Gallard88/Sunfish_MK2/2.Requirements/1.Requirements.md

ROSV Sunfish, MK2
=======

Processor
-----------
* Single Board Computer (SBC)
* Linux based OS.
* Capable of running the ROS framework.

Sensors
-----------
* Supply voltage measurement.
* Current measurement.
* Internal Temperature Monitoring.
* External Temperature Monitoring.
* Depth Measuring.
* Capable of Inertial Navigation.

Camera
-----------
* Minimum 640x480.
* Minimum 10fps resolution.
* Maximum 500ms delay.
* Sufficient lighting to see while at maximum depth.
* Sufficient storage to record all video while operating.

Motion/Control
-----------
* 4 axis control (Forward, Strafe, Turn, Dive).
* Minimum 1 hour run time.

Environment
-----------
* Able to dive to a depth of at least 5 meters.
* Tetherd to a surface control system.
* Dimensions of less than 40cm W x 40cm L x 25 cm H.

Tether 
=======

The tether will consist of an Ethernet cable & 2 conductors carrying power.

Ethernet:
-----------
* Cable type: CAT5 or 6.
* Length: 30m.

Power Cables
-----------
* Cable Type: 8 - 12 AWG, preferably 10.
* Length: 30m.

SCS
=======

The SCS contains the power supply for the entire ROSV system. It also contains the brains behind the LAN.
Thus is will need to manage several batteries and will provide power to a number of sub systems. It will be handy if the system can charge the batteries in system.

Power In
-----------
* Min 3x 12V SLA Batteries.
* Intergrated SLA battery charger.

Power Out
-----------
* Min 2x High current fused outputs.
* Min 1x Low current fused outputs.
* Min 1x USB 5V Outputs.

Display
-----------
Minimum Resolution 1024x768.

Processor
-----------
* Single Board Computer (SBC).
* Linux based OS.
* Attached Monitor.
* Runs ROS framework.

Motion/Control
-----------
* Gamepad and/or Joystick3.
* Keyboard and Mouse.

Network
-----------
* Wifi Access Point.
* DHCP Server.
* Network switch, Min 4 ports, Gigabit Ethernet.

Environment
-----------
* Self Contained.
* Easy to transport.
* Water Resistant.
* Small form factor where possible.
