Gallard88/Sunfish_MK2/2.Requirements/2.Tether_Hardware_Requirements.md

Tether 
=======

The tether will consist of an Ethernet cable & 2 conductors carrying power.

Ethernet:
-----------
Cable type: CAT5e or 6
Length: 30m.

Power Cables
-----------
Cable Type: 8 - 12 AWG, preferably 10.
Length: 30m.
