Gallard88/Sunfish_MK2/2.Requirements/4.ROSV_Firmware_Requirements.md

Sensor Data
-----------

Supply Voltage
Current Measurement
Internal Temperature
External Temperature
Depth Measuring
Interntial Navigation:
* Roll
* Pitch
* Yaw

High Side switch. 
PWM Frequency (0 - 2 KHz)
PWM Duty (0 - 100%)

System Values
-----------

Supply Voltage, 16bit, unsigned, millivolts.
Current Measurement, 16bit, unsigned, milliamps.
Internal Temperature, 16bit, signed, 1 degrees Centigrade.
External Temperature, 16bit, signed, 1 degrees Centigrade.
Depth Pressure, 32 bit, signed, Pascals.
Calulated Depth, 32 bit signed, millimeters.
