Gallard88/Sunfish_MK2/2.Requirements/5.USB_Coms_Protocol_Spec.md

USB Coms Protocol.
=======

Packet Types:
-----------
0x0100 - Sensor Data
0x0101 - INS Data
0x0102 - Supply Voltage Data
0x0103 - Supply Current Data

0x0200 - Fluid Density
0x0201 - Set Output
0x0202 - Disable All Outputs

Packets To uC.
=======

1. Set Fluid Density.
-----------
Freq: n/a
Byte
00 - 0x02 Packet Type (MSB)
01 - 0x00 Packet Type (LSB)
02 - Fluid Density (MSB)
03 - Fluid Density (LSB) 

2. Set Output.
-----------
Freq: n/a
Byte
00 - 0x02 Packet Type (MSB)
01 - 0x01 Packet Type (LSB)
02 - Output Channel #
03 - Duty (%)

2. Disable All Outputs
-----------
Freq: n/a
Byte
00 - 0x02 Packet Type (MSB)
01 - 0x02 Packet Type (LSB)
02 - 0xAA
03 - 0x55

Packets From uC.
=======

1. Sensor Data
-----------
Freq: 1Hz
Byte
00 - 0x01 Packet Type (MSB)
01 - 0x00 Packet Type (LSB)
02 - Supply Voltage (MSB)
03 - Supply Voltage (LSB) 
04 - Supply Current (MSB)
05 - Supply Current (LSB) 
06 - Internal Temperature (MSB)
07 - Internal Temperature (LSB) 
08 - External Temperature (MSB)
09 - External Temperature (LSB) 

1. INS Data
-----------
00 - 0x01 Packet Type (MSB)
01 - 0x01 Packet Type (LSB)
02 - Fluid Density (MSB)
03 - Fluid Density (LSB) 

04 - Depth Pressure (MSB)
05 - Depth Pressure  
06 - Depth Pressure  
07 - Depth Pressure (LSB) 

08 - Calulated Depth (MSB)
09 - Calulated Depth
10 - Calulated Depth
11 - Calulated Depth (LSB) 

To Add:
Interntial Navigation:
* Roll
* Pitch
* Yaw

3. Supply Voltage Data
-----------
Measured Supply Voltage. Sampled at 10Hz.
Freq: 1Hz
Byte
00 - 0x01 Packet Type (MSB)
01 - 0x02 Packet Type (LSB)
02 - Supply Voltage[0] (MSB)
03 - Supply Voltage[0] (LSB)
...
20 - Supply Voltage[9] (MSB)
21 - Supply Voltage[9] (LSB) 

4. Supply Current Data
-----------
Measured Supply Voltage. Sampled at 100Hz.
Freq: 1Hz
Byte
 00 - 0x01 Packet Type (MSB)
 01 - 0x03 Packet Type (LSB)
 02 - Supply Current[0] (MSB)
 03 - Supply Current[0] (LSB)
...
200 - Supply Current[100] (MSB)
201 - Supply Current[100] (LSB)
