Gallard88/Sunfish_MK2/Calculations/Hole_Notes.md

Primary Tube
-----------
1. Vacuum Seal
2. Power In
3. USB 1
4. USB 2
5. Ethernet
6. Depth Sensor
7. ???

Secondary Tube, Plate A
-----------
1. Vacuum Seal
2. Supply In +
3. Supply In -
4. USB In
5. Power Out 1
6. Power Out 2
7. ???

Secondary Tube, Plate B
-----------
1. TC 1 + 2
2. TC 3 + 4
3. TC 5 + 6
4. TC 7 + 8
5. TC 9 + 10 (?)
6. Lighting Ch 1
7. Lighting Ch 2
