Gallard88/Sunfish_MK2/Calculations/Output_Notes.md

8 Thrusters
2 Light Outputs
2 Extra outputs
---
12 Channels

= 24 Terminals.

12x 3.5mm screw terminals
= 42mm

12x 3.81mm screw terminals
= 45.72mm

Control Box
6x 12v Socket + Switch
Up to 6 12V Batteries.
Hot plug support.
In built charger.
