Gallard88/Sunfish_MK2/Research/SingleBoardProcessors.md

Single Board Computers
===========

Raspberry Pi 2
-----------
Price: $35USD.
Processor: 900 MHz quad-core ARM Cortex-A7
RAM: 1GB DDR3
GPU: Mali400MP2 GPU @600MHz
Product size: 85.6mm × 56.5mm
Weight: 50g
Ethernet: 10/100M Ethernet RJ45
USB: 
* Four USB 2.0 HOST.

Supported OS:
* Ubuntu 
* Custom Debian 
* Windows 10 IoT

Other features:	

Raspberry Pi 3
-----------
Price: $35USD.
Processor: 1.2GHz 64-bit quad-core ARM Cortex-A53 CPU
RAM: 1GB DDR3
GPU: Mali400MP2 GPU @600MHz
Product size: 85.6mm × 56.5mm
Weight: 50g
Ethernet: 10/100M Ethernet RJ45
USB: 
* Four USB 2.0 HOST.

Supported OS:
* Ubuntu 
* Custom Debian 
* Windows 10 IoT

Other features:	
* Onboard WIFI, Bluetooth 4.1

Odroid XU4
-----------
Price: $74USD.
Processor: Exynos 5422 Octa big.LITTLE ARM Cortex-A15 @ 2.0 GHz quad-core and Cortex-A7 quad-core CPUs
RAM: 2GB DDR3
GPU: Mali-T628 MP6 
Product size: 83mm × 59mm
Weight: 50g
Ethernet: 10/100/1000M Ethernet RJ45
USB: 
* Four USB 2.0 HOST.
* One  USB 2.0 OTG

Supported OS:
* Android 
* Ubuntu 
* Debian 

Odroid-C1+
-----------
Price: $32USD.
Processor: Amlogic S805, 4× Cortex-A5 @ 1.5 GHz
RAM: 1GB DDR3
GPU: Mali450MP2 GPU
Product size: 85mm × 56mm
Weight: 50g
Ethernet: 10/100/1000M Ethernet RJ45
USB: 
* Four USB 2.0 HOST.
* One  USB 2.0 OTG

Supported OS:
* Android 
* Ubuntu 
* Debian 

Other features:	
* 40 Pins Header,compatible with Raspberry Pi B+

Odroid-C2
-----------
Price: $40USD.
Processor: Amlogic S905, 4× Cortex-A53 (ARMv8 64bit)
RAM: 2GB DDR3
GPU: Mali450MP3
Product size: 85mm × 56mm
Weight: 50g
Ethernet: 10/100/1000M Ethernet RJ45
USB: 
* Four USB 2.0 HOST.
* One  USB 2.0 OTG

Supported OS:
* Android 
* Ubuntu 
* Debian 

Other features:	
* 40 Pins Header,compatible with Raspberry Pi B+

Orange Pi Plus
-----------
Price: $40USD.
Processor: H3 Quad-core Cortex-A7 H.265/HEVC 4K
RAM: 1GB DDR3
GPU: Mali400MP2 GPU @600MHz
Product size: 108mm × 60mm
Weight: 50g
Ethernet: 10/100/1000M Ethernet RJ45
USB: 
* Four USB 2.0 HOST.
* One  USB 2.0 OTG

Supported OS:
* Android 
* Ubuntu 
* Debian 
* Rasberry Pi Image

Other features:	
* Onboard WIFI, Realtek RTL8189ETV, IEEE 802.11 b/g/n
* 40 Pins Header,compatible with Raspberry Pi B+
