Gallard88/Sunfish_MK2/Testing/WebCamLight_RevA.FootprintCheck.xlsx

Description | Designator | Footprint | LibRef | Manufacturer | Manufacturer P/N | Checked
WL-SMCW SMD CHIP LED WATERCLEAR | LD1_A1, LD1_A2, LD1_A3, LD1_A4, LD1_A5, LD1_A6, LD1_A7, LD1_A8, LD1_A9, LD1_A10, LD1_A11, LD1_A12, LD1_A13, LD1_A14, LD1_A15, LD1_A16, LD2_A1, LD2_A2, LD2_A3, LD2_A4, LD2_A5, LD2_A6, LD2_A7, LD2_A8, LD2_A9, LD2_A10, LD2_A11, LD2_A12, LD2_A13, LD2_A14, LD2_A15, LD2_A16, LD3_A1, LD3_A2, LD3_A3, LD3_A4, LD3_A5, LD3_A6, LD3_A7, LD3_A8, LD3_A9, LD3_A10, LD3_A11, LD3_A12, LD3_A13, LD3_A14, LD3_A15, LD3_A16 | Wurth_1206_Led | LED_White_1206 | Wurth | 158301260 | Visually Inspected
20-60mA Led Driver | U1_A1, U1_A2, U1_A3, U1_A4, U1_A5, U1_A6, U1_A7, U1_A8, U1_A9, U1_A10, U1_A11, U1_A12, U1_A13, U1_A14, U1_A15, U1_A16 | SOT192P237X110-4M | IC_LED_DRV_BCR401R | Infineon | BCR401R | Visually Inspected
