Gallard88/Sunfish_MK2/Testing/Sunfish_ECU_RevA.FootprintCheck.xlsx

Description | Designator | Footprint | LibRef | Manufacturer | Manufacturer P/N | Checked
Ferrite Bead, 6A | FB1, FB2, L1_UF1, L1_UF2, L1_UF3, L1_UF4, L1_UF5, L1_UF6, L1_UF7, L1_UF8, L1_UF9, L1_UF10, L1_UF11, L1_UF12, L3, L5 | 1806 | IND_FERRITE_ BLM41PG600SN1L | MURATA | BLM41PG600SN1L
 | INS1 | IC_INC_BNO055 | IC_INS_BNO055
WR-TBL Terminal Blocks Serie 2301 - 3.50 mm with Rising Clamp | J1, J2, J3, J4, J5, J6 | 691230110004 | TRM_4_Double | W¨¹rth Elektronik eiSos GmbH
CON_4_Pos_Header | J7, J8 | DF13-4P-1.25DSA | CON_4_Pos_Header | Hirose Electric Co Ltd | DF13-4P-1.25DSA
FIXED IND 4.7UH 6.2A 34 MOHM | L2 | Wurth744771156 | IND_4.7uH_6A2 | Wurth Electronics Inc | 74437356047
CHOKE COM MODE ULTRA HC 100 OHMS | L4 | Choke_CM5441Z101B-10 | CHOKE_COM_MODE_100MHz | Laird-Signal Integrity Products | CM5441Z101B-10
WL-SMCW SMD CHIP LED WATERCLEAR | LD1, LD2, LD3 | 0805DIODE | LED_Green_0805 | Wurth | 150080VS75000
USB B Socket Horizontal | SK1 | USB_B_Horizontal | USB_B_Horizontal | Wurth Electronics Inc | 61400416121
IDC BOX HEADER .100" 20POS | TRM1 | IDC20_BOXED | TRM_IDC20 | CNC Tech | 3020-20-0100-00
TERM BLOCK 2POS HORIZ 7.62MM T/H | TRM3 | TERM_2POS_HORIZ_7.62MM | TRM_2way_ScrewTerminal_7.62mm | Altronics | P4343
TERM BLOCK 2POS HORIZ 5.08MM T/H | TRM6 | TERM_2POS_HORIZ_5.08MM | TRM_2way_ScrewTerminal | Wurth Electronics Inc | 691216510002
64 Pin, 512KB Flash, 128K SRAM | U1 | TSQFP50P1200X1200X160-64M | IC_MICRO_ATSAM4S8BA-AU | Atmel | ATSAM4S8BA-AU
TVS DIODE 5.25VWM 8SOIC | U2 | SO-8 | IC_USB_Transorb | STMicroelectronics | USB6B1RL
IC HISIDE PWR SWITCH 4CH PDSO-20 | U3, U4, U5 | SOIC127P1030X265-20M | IC_HSS_BTS724G | Infineon | BTS724GXUMA1
SMPS | U6 | PSOP-8 | IC_SMPS_TPS54531 | TI | TPS54531DDA
IC REG LDO 3.3V 0.7A SOT25 | U7 | SOT-25-A | IC_XC6210B332MR-G | Torex Semiconductor Ltd | XC6210B332MR-G
MCP3202, 12 Bit, 2 CH ADC | U8 | SO-8 | IC_ADC_MCP3202 | Microchip | MCP3202
IC DATAFLASH 32MB 85MHZ 8SOIC | U9 | SOIC127P800X216-8M | IC_Dataflash_32MBit | Adesto Technologies | AT45DB321E-SHF-T
IC OPAMP CURR SENSE 230KHZ 8SOIC | U10 | SOIC127P600X168_HS-8M | IC_OPAMP_MAX9920+ | Maxim Intergrated | MAX9920ASA+
Crystal 12.0000MHz 30ppm 12pF 40 Ohm -20°C - 70°C Surface Mount 4-SMD, No Lead (DFN, LCC) | X1 | XTAL_5X3.2_SMD | XTAL_12MHZ_SMT | TXC CORPORATION | 7B-12.000MAAE-T
