Gallard88/Sunfish_MK2/Testing/SurfaceControlSystem_RevA.FootprintCheck.xlsx

Description | Designator | Footprint | LibRef | Manufacturer P/N | Checked
FUSE CLIP BLADE 500V 30A PCB | F1, F2, F3, F4, F5_UB1, F5_UB2, F5_UB3, F5_UB4 | FUSEHOLDER_BLADE | FUSE_BLADE_500V_30A_PCB | 3522-2
CON_5mm_6.3MM_SPADE | J1_UB1, J1_UB2, J1_UB3, J1_UB4, J2_UB1, J2_UB2, J2_UB3, J2_UB4 | CON_5mm_6.3MM_SPADE | CON_5mm_6.3MM_SPADE | P-850
FIXED IND 4.7UH 6.2A 34 MOHM | L2 | Wurth744771156 | IND_4.7uH_6A2 | 74437356047
FIXED IND 56UH 2.01A 110 MOHM | L3 | Wurth744771156 | IND_56uH_2.01A | 744771156
MOSFET N-CH 30V 20A LFPAK | Q1_UB1, Q1_UB2, Q1_UB3, Q1_UB4, Q2_UB1, Q2_UB2, Q2_UB3, Q2_UB4 | SO-8 | Q_AO4578 | AO4578
USB A Double Socket | SKT2 | USB_A_DoubleSocket | USB_A_Double
TERM BLOCK 2POS HORIZ 7.62MM T/H | TRM1, TRM3, TRM4 | TERM_2POS_HORIZ_7.62MM | TRM_2way_ScrewTerminal_7.62mm | P4343
TERM BLOCK 2POS HORIZ 5.08MM T/H | TRM2, TRM5, TRM6, TRM7 | TERM_2POS_HORIZ_5.08MM | TRM_2way_ScrewTerminal | 691216510002
SMPS | U1 | PSOP-8 | IC_SMPS_TPS54531 | TPS54531DDA
Ideal Diode Controller | U2_UB1, U2_UB2, U2_UB3, U2_UB4 | TSOP65P490X110-8M | IC_LTC4359 | LTC4359CMS8#PBF
IC REG BUCK 5V 1A 8SOPWRPAD | U3 | PSOP-8 | IC_REG_LM22675 | LM22675MRE-5.0/NOPB
