Gallard88/Sunfish_MK2/Calculations/Cable_Loss.ods

Sheet: Cables_Loss
Cable Data |  |  |  |  |  | Voltage Drop
Guage | Diameter | Ohms/Km | Ohms/m | Area (mm^2) | Current: | 5 | A | Current: | 10 | A | Current: | 15 | A | Current: | 20 | A | Current: | 25 | A
 |  |  |  |  | 30 | 50 | 100 | 30 | 50 | 100 | 30 | 50 | 100 | 30 | 50 | 100 | 30 | 50 | 100
0 | 8.3 | 0.3 | 0.0003 | 53.4561625 | 0.09 | 0.15 | 0.30 | 0.18 | 0.30 | 0.60 | 0.27 | 0.45 | 0.90 | 0.36 | 0.60 | 1.20 | 0.45 | 0.75 | 1.50
1 | 7.3 | 0.4 | 0.0004 | 42.31379729 | 0.12 | 0.20 | 0.40 | 0.24 | 0.40 | 0.80 | 0.36 | 0.60 | 1.20 | 0.48 | 0.80 | 1.60 | 0.60 | 1.00 | 2.00
2 | 6.5 | 0.5 | 0.0005 | 33.1830724 | 0.15 | 0.25 | 0.50 | 0.30 | 0.50 | 1.00 | 0.45 | 0.75 | 1.50 | 0.60 | 1.00 | 2.00 | 0.75 | 1.25 | 2.50
3 | 5.8 | 0.7 | 0.00065 | 26.42079422 | 0.20 | 0.33 | 0.65 | 0.39 | 0.65 | 1.30 | 0.59 | 0.98 | 1.95 | 0.78 | 1.30 | 2.60 | 0.98 | 1.63 | 3.25
4 | 5.1 | 0.8 | 0.0008 | 20.42820623 | 0.24 | 0.40 | 0.80 | 0.48 | 0.80 | 1.60 | 0.72 | 1.20 | 2.40 | 0.96 | 1.60 | 3.20 | 1.20 | 2.00 | 4.00
5 | 4.6 | 1.0 | 0.001 | 16.61902514 | 0.30 | 0.50 | 1.00 | 0.60 | 1.00 | 2.00 | 0.90 | 1.50 | 3.00 | 1.20 | 2.00 | 4.00 | 1.50 | 2.50 | 5.00
6 | 4.1 | 1.2 | 0.0012 | 13.20254313 | 0.36 | 0.60 | 1.20 | 0.72 | 1.20 | 2.40 | 1.08 | 1.80 | 3.60 | 1.44 | 2.40 | 4.80 | 1.80 | 3.00 | 6.00
7 | 3.6 | 1.6 | 0.0016 | 10.1787602 | 0.48 | 0.80 | 1.60 | 0.96 | 1.60 | 3.20 | 1.44 | 2.40 | 4.80 | 1.92 | 3.20 | 6.40 | 2.40 | 4.00 | 8.00
8 | 3.2 | 2.0 | 0.002 | 8.042477193 | 0.60 | 1.00 | 2.00 | 1.20 | 2.00 | 4.00 | 1.80 | 3.00 | 6.00 | 2.40 | 4.00 | 8.00 | 3.00 | 5.00 | 10.00
9 | 2.9 | 2.6 | 0.0026 | 6.605198554 | 0.78 | 1.30 | 2.60 | 1.56 | 2.60 | 5.20 | 2.34 | 3.90 | 7.80 | 3.12 | 5.20 | 10.40 | 3.90 | 6.50 | 13.00
10 | 2.6 | 3.2 | 0.0032 | 5.309291585 | 0.96 | 1.60 | 3.20 | 1.92 | 3.20 | 6.40 | 2.88 | 4.80 | 9.60 | 3.84 | 6.40 | 12.80 | 4.80 | 8.00 | 16.00
11 | 2.3 | 4.1 | 0.0041 | 4.154756284 | 1.23 | 2.05 | 4.10 | 2.46 | 4.10 | 8.20 | 3.69 | 6.15 | 12.30 | 4.92 | 8.20 | 16.40 | 6.15 | 10.25 | 20.50
12 | 2.0 | 5.2 | 0.0052 | 3.141592654 | 1.56 | 2.60 | 5.20 | 3.12 | 5.20 | 10.40 | 4.68 | 7.80 | 15.60 | 6.24 | 10.40 | 20.80 | 7.80 | 13.00 | 26.00
13 | 1.8 | 6.5 | 0.0065 | 2.544690049 | 1.95 | 3.25 | 6.50 | 3.90 | 6.50 | 13.00 | 5.85 | 9.75 | 19.50 | 7.80 | 13.00 | 26.00 | 9.75 | 16.25 | 32.50
14 | 1.6 | 8.3 | 0.0083 | 2.010619298 | 2.49 | 4.15 | 8.30 | 4.98 | 8.30 | 16.60 | 7.47 | 12.45 | 24.90 | 9.96 | 16.60 | 33.20 | 12.45 | 20.75 | 41.50
18 | 1.0 | 21.0 | 0.021 | 0.785398163 | 6.30 | 10.50 | 21.00 | 12.60 | 21.00 | 42.00 | 18.90 | 31.50 | 63.00 | 25.20 | 42.00 | 84.00 | 31.50 | 52.50 | 105.00
19 | 0.9 | 26.0 | 0.026 | 0.636172512 | 7.80 | 13.00 | 26.00 | 15.60 | 26.00 | 52.00 | 23.40 | 39.00 | 78.00 | 31.20 | 52.00 | 104.00 | 39.00 | 65.00 | 130.00
20 | 0.8 | 33.0 | 0.033 | 0.502654825 | 9.90 | 16.50 | 33.00 | 19.80 | 33.00 | 66.00 | 29.70 | 49.50 | 99.00 | 39.60 | 66.00 | 132.00 | 49.50 | 82.50 | 165.00
 |  |  | This is the voltage drop in a cable for a given length and current
 |  |  | This assumes that there is a supply and return conductor.

Sheet: Cables
Exchange Rate (US => AUD) |  |  | 0.71
Cable by the meter |  |  |  |  |  | Distance / Cost
Supplier | P/N | # Cores | AWG | $/m |  | 30 | 50 | 100
Altronics | W0570 | 3 | 18 | $2.75 |  | $55.00 | $91.67 | $183.33
 | W4220 | 5 | 20 | $2.95 |  | $35.40 | $59.00 | $118.00
 | W4222 | 7 | 19 | $4.75 |  | $40.71 | $67.86 | $135.71
 | W4100 | 1 | 8 | $3.90 |  | $234.00 | $390.00 | $780.00
Jaycar | WH3080 | 1 | 13 | $2.20 |  | $132.00 | $220.00 | $440.00
 | WH3077 | 2 | 16 | $4.33 |  | $130.00 | $216.67 | $433.33
 | WH3060 | 1 | 8 | $3.60 |  | $216.00 | $360.00 | $720.00
 | WH3082 | 1 | 13 | $2.20 |  | $132.00 | $220.00 | $440.00
 | WH3066 | 1 | 4 | $8.90 |  | $534.00 | $890.00 | $1,780.00
Element 14 | PP001191 | 1 | 10 | $2.30 |  | $138.00 | $230.00 | $460.00
 | PP001275 | 1 | 10 | $2.30 |  | $138.00 | $230.00 | $460.00
30.5m Cable Roll
Supplier | P/N | # Cores | AWG | $
Digikey | A541401R-100-ND | 1 | 14 | $51.69 |  | $103.38
 | C76822B-100-ND | 1 | 12 | $71.89 |  | $143.77
 | C76822R-100-ND | 1 | 12 | $71.89 |  | $143.77
 | C76832B-100-ND | 1 | 10 | $100.65 |  | $201.30
 | C76832R-100-ND | 1 | 10 | $100.65 |  | $201.30
http://www.ebay.com/itm/100-Ft-10-Gauge-Speaker-Wire-Cable-Car-Home-Audio-AWG-100-Black-Red-Zip-Wire-/180823519922 |  |  | Price | Shipping
100' 10 AWG, Red + Black |  |  | $43.59 | $42.25 | $85.85
