Gallard88/Sunfish_MK2/Modelling/tether_analysis/tether_analysis.asc

C1: polcap; 3300µ; V=35 Irms=770m Rser=0.09 Lser=0
C2: polcap; 220µ; V=35 Irms=770m Rser=0.09 Lser=0 mfg="Nichicon" pn="UPL1V221MPH6" type="Al electrolytic"
C3: polcap; 220µ; V=35 Irms=770m Rser=0.09 Lser=0 mfg="Nichicon" pn="UPL1V221MPH6" type="Al electrolytic"
C4: polcap; 3300µ; V=35 Irms=770m Rser=0.09 Lser=0
C5: polcap; 220µ; V=35 Irms=770m Rser=0.09 Lser=0 mfg="Nichicon" pn="UPL1V221MPH6" type="Al electrolytic"
C7: polcap; 220µ; V=35 Irms=770m Rser=0.09 Lser=0 mfg="Nichicon" pn="UPL1V221MPH6" type="Al electrolytic"
C8: polcap; 220µ; V=35 Irms=770m Rser=0.09 Lser=0 mfg="Nichicon" pn="UPL1V221MPH6" type="Al electrolytic"
C9: polcap; 220µ; V=35 Irms=770m Rser=0.09 Lser=0 mfg="Nichicon" pn="UPL1V221MPH6" type="Al electrolytic"
C10: polcap; 3300µ; V=35 Irms=770m Rser=0.09 Lser=0
C11: polcap; 3300µ; V=35 Irms=770m Rser=0.09 Lser=0
C13: cap; 33000µ
C14: cap; 33000µ
C15: cap; 33000µ
C16: cap; 33000µ
C17: cap; 3300µ
C18: cap; 3300µ
C19: cap; 3300µ
C20: cap; 3300µ
D1: TVSdiode; SMBJ24CA
D2: TVSdiode; SMBJ24CA
L1: ind; 21µ
L2: ind; 28µ
L3: ind; 48µ
L4: ind; 36µ
L5: ind; 59µ
L6: ind; 36µ
R13: res; 24
R17: res; 0.2
R18: res; 0.12
R19: res; 0.39
R20: res; 86
R21: res; 1.8
R22: res; 86
R23: res; 1.8
R24: res; 86
R25: res; 1.8
R26: res; 86
R27: res; 1.8
R28: res; 86
R29: res; 1.8
R30: res; 86
R31: res; 1.8
R32: res; 86
R33: res; 1.8
R34: res; 86
R35: res; 1.8
R36: res; 0.65
R37: res; 1.26
R38: res; 2.6
S2: sw; SW1
S3: sw; SW1
V1: voltage; 14
V2: voltage; PULSE(0 17 1 .001 .001 1)
V5: voltage; PULSE(0 17 1)
Named nets: 0, THRUSTER_EN_CH1, SUB_SIDE, THRUSTER_EN_CH2
.tran 6
8 Guage, 30m
.model SW1 SW(Ron=0.000001 Roff=1Meg Vt=.5 Vh=-.4)
8 Guage, 50m
13 Guage, 30m
13 Guage, 50m
18 Guage, 30m
18 Guage, 50m
Static load, i.e. SBC
