Gallard88/Sunfish_MK2/Modelling/load_balancing/Load_Balance.asc

C1: cap; 10n
C4: cap; 10n
C6: cap; 10n
M1: nmos; STS12NF30L
M2: nmos; STS12NF30L
M3: nmos; STS12NF30L
M4: nmos; STS12NF30L
M5: nmos; STS12NF30L
M6: nmos; STS12NF30L
R1: res; 10
R2: res; 10k
R3: res; 1k
R4: res; 100k
R5: res; 1k
R6: res; 100k
R7: res; 1k
R8: res; 1k
R9: res; 10
R10: res; 10k
R11: res; 1k
R12: res; 100k
R13: res; 5
R14: res; 1k
R15: res; 10
R16: res; 10k
U1: LTC4359
U2: LTC4359
U3: LTC4359
V1: voltage; 14
V2: voltage; 14.51
V3: voltage; 14.5
V4: voltage; PULSE(0 9 0.1)
Named nets: 0, ENABLE, VCC_BATT
.tran 5
