Gallard88/Sunfish_MK2/Modelling/motor_starting/Motor_startng_model.asc

C1: cap; 3300µ
R1: res; 11
R2: res; 1.8
S1: sw; SW1
V1: voltage; 12.8
V2: voltage; PULSE(0 30 1)
Named nets: 0
.tran 2
.model SW1 SW(Ron=0.000001 Roff=1Meg Vt=.5 Vh=-.4)
