Gallard88/Sunfish_MK2/Modelling/tether_analysis/SystemSimulation.asc

C1: cap; 10n
C2: polcap; 220µ; V=35 Irms=770m Rser=0.09 Lser=0 mfg="Nichicon" pn="UPL1V221MPH6" type="Al electrolytic"
C3: polcap; 220µ; V=35 Irms=770m Rser=0.09 Lser=0 mfg="Nichicon" pn="UPL1V221MPH6" type="Al electrolytic"
C4: cap; 10n
C5: polcap; 220µ; V=35 Irms=770m Rser=0.09 Lser=0 mfg="Nichicon" pn="UPL1V221MPH6" type="Al electrolytic"
C6: cap; 10n
C7: polcap; 220µ; V=35 Irms=770m Rser=0.09 Lser=0 mfg="Nichicon" pn="UPL1V221MPH6" type="Al electrolytic"
C8: polcap; 220µ; V=35 Irms=770m Rser=0.09 Lser=0 mfg="Nichicon" pn="UPL1V221MPH6" type="Al electrolytic"
C9: polcap; 220µ; V=35 Irms=770m Rser=0.09 Lser=0 mfg="Nichicon" pn="UPL1V221MPH6" type="Al electrolytic"
C10: polcap; 220µ; V=35 Irms=770m Rser=0.09 Lser=0
C11: polcap; 220µ; V=35 Irms=770m Rser=0.09 Lser=0
C13: cap; 2.2µ
C14: cap; 2.2µ
C15: cap; 2.2µ
C16: cap; 2.2µ
C17: cap; 2.2µ
C18: cap; 2.2µ
C19: cap; 2.2µ
C20: cap; 2.2µ
D1: TVSdiode; SMBJ24CA
D2: TVSdiode; SMBJ24CA
L1: ind; 21µ
L2: ind; 28µ
L3: ind; 48µ
L4: ind; 36µ
L5: ind; 59µ
L6: ind; 36µ
M1: nmos; STS12NF30L
M2: nmos; STS12NF30L
M3: nmos; STS12NF30L
M4: nmos; STS12NF30L
M5: nmos; STS12NF30L
M6: nmos; STS12NF30L
R1: res; 10
R2: res; 10k
R3: res; 1k
R4: res; 100k
R5: res; 1k
R6: res; 100k
R7: res; 1k
R8: res; 1k
R9: res; 10
R10: res; 10k
R11: res; 1k
R12: res; 100k
R13: res; 12
R14: res; 1k
R15: res; 10
R16: res; 10k
R17: res; 0.2
R18: res; 0.12
R19: res; 0.39
R20: res; 18.3
R21: res; 1.8
R22: res; 18.3
R23: res; 1.8
R24: res; 18.3
R25: res; 1.8
R26: res; 18.3
R27: res; 1.8
R28: res; 18.3
R29: res; 1.8
R30: res; 18.3
R31: res; 1.8
R32: res; 18.3
R33: res; 1.8
R34: res; 18.3
R35: res; 1.8
R36: res; 0.65
R37: res; 1.26
R38: res; 2.6
S2: sw; SW1
S3: sw; SW1
U1: LTC4359
U2: LTC4359
U3: LTC4359
V1: voltage; 14
V2: voltage; 14
V3: voltage; 14
V4: voltage; PULSE(0 9 0.1)
V5: voltage; PULSE(0 17 1)
Named nets: 0, ENABLE, THRUSTER_EN, SUB_SIDE, VCC_BATT
.tran 5
8 Guage, 30m
.model SW1 SW(Ron=0.000001 Roff=1Meg Vt=.5 Vh=-.4)
8 Guage, 50m
13 Guage, 30m
13 Guage, 50m
18 Guage, 30m
18 Guage, 50m
