Gallard88/Sunfish_MK2/(list of files, drawings)

Other design files:
Altium_Sketches/ROSV_Arch_Idea1.SchDoc
Altium_Sketches/ROSV_Arch_Idea2.SchDoc
Altium_Sketches/ROSV_Arch_Idea2_Layout.SchDoc
Altium_Sketches/SCS_Layout.SchDoc
Altium_Sketches/System_Arch.SchDoc
