Gallard88/Sunfish_MK2/Testing/WebCamLight_TestPlan_Rev1.0.txt

WebCamLight Test Plan
Date: 16/05/2016
Rev 1.0

Tests to perform:

1. LED Current vs Voltage
LED branch should draw 20mA from 10V to 15V.
