Gallard88/Sunfish_MK2/(commit log)

2016-03-04 Added a list of suitable single board computers.
2016-03-04 Added cable cost for specific distance information.
    [Cable_Loss.ods]
2016-03-06 Added information about single board PC's
    [Sense_Resistor.ods]
2016-03-09 Added basic sketches relating to the system design.
    [ROSV_Arch.SchDoc, SCS_Layout.SchDoc, System_Arch.SchDoc]
2016-03-09 Fixed error in cable loss calculation.
    [Cable_Loss.ods]
2016-03-09 Added simulation showing that the load balancing circuit works.
2016-03-16 Added more cable types and suppliers.
    modified: Calculations/Cable_Loss.ods
    [Cable_Loss.ods]
2016-03-16 Added data to calculate the value of a sense resistor.
    modified: Calculations/Sense_Resistor.ods
    [Sense_Resistor.ods]
2016-03-16 Added quick and dirty calculations related to tube sizes.
    new file: Calculations/TubeCalculations.ods
    [TubeCalculations.ods]
2016-03-16 Added Design notes and concept notes.
    new file: Altium_Sketches/ROSV_Arch_Idea2.SchDoc
    new file: Altium_Sketches/ROSV_Arch_Idea2_Layout.SchDoc
    new file: Design/Concept_Notes_1.md
    new file: Design/Concept_Notes_2.md
    new file: Design/Investigation_Notes/BoxDepth.md
    [ROSV_Arch_Idea1.SchDoc, ROSV_Arch_Idea2.SchDoc, ROSV_Arch_Idea2_Layout.SchDoc]
2016-03-17 Changed Sense resistor calulcations. It now supports non-semetrical measurements.
    [Sense_Resistor.ods]
2016-03-19 Added analysis of current drawn by the system at various stages of operation.
2016-04-18 Added concept note about LEDs
    new file: 3.Design/20160418_Concept_Notes_4.md
2016-04-18 Moved files into a more suitable directory
    renamed: Calculations/12V_SLA_Batteries.ods -> Research/12V_SLA_Batteries.ods
    renamed: Calculations/Enclosures.ods -> Research/Enclosures.ods
    renamed: Calculations/SeeedStudio_PCBs.ods -> Research/SeeedStudio_PCBs.ods
    [12V_SLA_Batteries.ods, Enclosures.ods, SeeedStudio_PCBs.ods]
2016-05-12 Added some power calculations to 12V SLA spreadsheet.
    [12V_SLA_Batteries.ods]
2016-05-16 Added new test plans and foot print checks for PCBAs
    [Sunfish_ECU_RevA.FootprintCheck.xlsx, SurfaceControlSystem_RevA.FootprintCheck.xlsx, WebCamLight_RevA.FootprintCheck.xlsx]
2016-06-06 Completed Visual inspection of Webcam Light footprints.
    [WebCamLight_RevA.FootprintCheck.xlsx]
